Bratwurst04/Kobra-Max-SKR3EZ-Klipper/README.md

# Anycubic Kobra Max with BTT SKR 3 EZ running Klipper
This repository documents my conversion of an original Anycubic Kobra Max to a BIGTREETECH SKR 3 EZ running Klipper.
The build retains most of the original printer hardware, including the Bowden extruder, motors, fans, external bed MOSFET and LeviQ strain-gauge probe.

This is primarily my own build record, and secondarily a reference for similar conversions. Start with the [dated status and intended Orca workflow](./docs/STATUS.md), then use the detailed documents below. The public cfg files remain an older reference, not the complete configuration read from the machine on 28 October 2026.

> [!WARNING]
> This repository is very much a work in progress!
> The wiring and earlier configurations have historical test reports from **my** Anycubic Kobra Max and SKR 3 EZ. The files in this tree have missing prerequisites and explicit local-identity placeholders; they are not a ready-to-run conversion package.
> Anycubic used multiple board and harness revisions, so verify all wiring, voltages, polarities and motor coil pairs on your own machine.
> Do not blindly copy configuration values. Incorrect wiring or configuration can damage hardware.

## Project overview

| Component | Documented build |
|---|---|
| Printer | Original Anycubic Kobra Max |
| Mainboard | BIGTREETECH SKR 3 EZ |
| MCU | STM32H723 |
| Stepper drivers | 4 × BTT EZ2209 v1.1 using UART |
| Host | Raspberry Pi Zero 2 W |
| Interface | Mainsail and Moonraker |
| Firmware | Klipper |
| Extruder | Original Bowden extruder |
| Hotend | Original-style replacement; exact installed model and sensor part unconfirmed. `EPCOS 100K B57560G104F` is the configured profile, not a physical part identification |
| Z probe | Original LeviQ strain gauge |
| Heated bed | Original bed and external MOSFET |
| Adaptive mesh | KAMP |

## What is documented

- Verified Anycubic-to-SKR wiring
- Original LeviQ probe output, reset and LED signals
- Logic-level conversion for the 5 V toolhead signals
- Stepper motor coil mapping
- Dual-Z wiring and synchronization issues
- External bed MOSFET wiring
- Split Klipper configuration files
- KAMP adaptive meshing and line purge
- Problems encountered during the conversion

## Documentation

| Document | Description |
|---|---|
| [Dated status](./docs/STATUS.md) | October read-only observations, laptop test readiness and remaining evidence limits |
| [Wiring](./docs/Wiring.md) | Verified connector mapping, voltages, motor coils and functional tests |
| [Configuration](./docs/config/config.md) | Purpose of each cfg file and values that must be changed or calibrated |
| [Issues](./docs/Issues.md) | Symptoms, causes and fixes encountered during the conversion |
| [Useful links](./Useful_links.md) | External projects, guides and discussions used during the build |
| [STL files](./docs/stl/) | Modified mounting and printhead parts used in this build |
| [Hardware](./docs/Hardware.md) | Exact hardware inventory, retained components, replacements and pending additions |
| [Project journey](./docs/Journey.md) | Chronological development history, failures, discoveries and verified conclusions |
| [Audit index](./AUDIT_REPORT.md) | English summary and immutable source for the historical September audit |
| [Repository working rules](./AGENTS.md) | Evidence, privacy and change-review rules for human and AI contributors |

## Historical verification record

The table below preserves the reports available to the September documentation. On **28 October 2026**, I reported no known current fault; the read-only snapshot and a laptop export were checked, but no laptop print or physical test was performed. Read [dated status](./docs/STATUS.md) before interpreting an old “pending” or “unresolved” label as today's machine state. Earlier success and later open reports both remain part of the history.

| Function | Status | Notes |
|---|---|---|
| X/Y/Z motion | ✅ Verified | Original motors |
| Extruder motion | ⚠️ Partially verified | Motion verified; later intermittent skipping/filament grinding unresolved |
| X/Y endstops | ✅ Verified | Original two-wire endstops |
| Original LeviQ | ⚠️ Reliability reopened | PB15/PB14 mapping verified; later intermittent trigger shifts remain unresolved |
| Z homing | ⚠️ Reliability reopened | Earlier success; later failed/false-trigger homing not closed |
| Hotend and thermistor | ⚠️ Partially verified | `Generic 3950` produced apparent underheating and severe extrusion resistance; reverting to the EPCOS-style curve improved manual 210 °C extrusion. Final PID/flow/max-flow/PA retests remain incomplete |
| Bed heater and MOSFET | ✅ Verified | Original external MOSFET retained |
| Original fans | ✅ Verified | Part-cooling and hotend fans |
| Toolhead LED | ✅ Verified | Controlled through PE5 |
| KAMP adaptive mesh | ⚠️ Integration verified | Adaptive mesh/line purge worked; later LeviQ reliability remains open |
| Pressure Advance | ⚠️ Retune pending | Earlier values were measured under previous Bowden/hotend states; latest hotend/thermistor rollback requires another PA calibration |
| Input Shaper | ✅ Calibration completed | X/Y MZV results recorded; later fast-print observations exist, but no controlled before/after ringing comparison or final saved cfg was supplied |
| Nozzle cleaner | ⚠️ Initial operation reported | Bed-mounted cleaner; final macro/start-sequence version not supplied |
| Host network | ⚠️ Unresolved / reopened | Later access outages remain unclosed |
| Filament runout sensor | ⏳ Pending | Wiring mapped to PC2; automatic start check and pause behavior were planned but not yet functionally verified |

The dated tuning and upgrade reports supplement the separate LeviQ/network investigations; their cross-branch order is not fully established. Earlier successes do not close those later-reported faults. The [configuration guide](./docs/config/config.md#input-shaper-and-nozzle-cleaner-versus-this-snapshot) distinguishes machine reports from features absent in the published cfg files.

## Intended everyday workflow

**Power on → open OrcaSlicer (Moonraker/Mainsail when needed) → Print.** This is the target workflow. The earlier working reference belongs to the home PC; laptop printing remains untried. The exact reviewed cube export passed static file checks only. Its first attended readiness and print session is still required; [status](./docs/STATUS.md) records the boundaries and known start-chain questions.

---

## Modifications

<details>
<summary><strong>Mainboard and chassis</strong></summary>

The original motherboard was replaced with a BTT SKR 3 EZ using four EZ2209 UART stepper drivers.

The board is mounted using a modified version of [this SKR 3 adapter](https://www.thingiverse.com/thing:6247028). My version is available here:

- [Kobra Max SKR 3 adapter plate](./docs/stl/Kobra%20Max%20SKR3%20Adapter%20plate.stl)

The modified plate moves the mounting holes and allows ordinary 3 mm screws instead of heat-set inserts.

The chassis was cut to provide access to the SKR microSD slot and USB-B connector. The exposed metal edges were covered after cutting.

</details>

<details>
<summary><strong>Wiring</strong></summary>

The original harnesses were mapped, depinned, re-crimped and moved into connector housings compatible with the SKR 3 EZ.

Most of the original wires are black, so every conductor was labelled before the original connectors were removed.

The complete verified mapping is documented in [Wiring.md](./docs/Wiring.md).

</details>

<details>
<summary><strong>Printhead and hotend</strong></summary>

The original printhead cover broke and was replaced with a heavily modified version of [this model](https://www.thingiverse.com/thing:5380573).

The modified files are available in [`docs/stl`](./docs/stl/).

The replacement cover required additional clearance around the LeviQ load cell. Insufficient clearance caused false probe triggers.

The original hotend was damaged and replaced with a similar original-style hotend.

</details>

<details>
<summary><strong>Display</strong></summary>

The original Anycubic display is not used in this build. It is proprietary and is not directly supported by the current Klipper configuration.

Mainsail is used as the primary interface.

</details>

## Work recorded before the October return

These items preserve earlier development questions. S01 now captures definitions that were absent from the public reference, including wipe and runout setup; configuration presence does not establish physical function. Use the [dated status](./docs/STATUS.md) for the current scope.

### Tuning

- PLA temperature/flow trials and X/Y Input Shaper calibration completed; see [the tuning follow-up](./docs/Journey.md#tuning-and-hardware-upgrade-follow-up)
- Retraction result inconclusive; sustained maximum flow and quality-focused speed limits not established
- Post-shaper fast-print observations are documented, but no controlled before/after ringing comparison was supplied
- Hotend sensor-profile troubleshooting now favors the published EPCOS-style curve on this machine; final PID, flow, max-flow and PA retests after the latest hotend work are still pending
- Intermittent extrusion and thermistor history remains relevant alongside LeviQ/network reliability

### Accessories

- Filament runout sensor
- USB accelerometer used for calibration; final live configuration not included
- Bed-mounted nozzle cleaner initially working; final start-sequence validation not documented
- Optional KlipperScreen display
- Raspberry Pi and USB-hub enclosures

### Possible future upgrades

- Quieter power-supply fan
- Direct drive
- Different hotend or printhead
- PEI build surface
- Chassis LED strip
- Replacement X/Y/Z motors
- Home Assistant integration
- Eddy-current probe

## How-to guide

A full start-to-finish installation guide is not available yet.

For now, the repository should be treated as:

1. A verified wiring reference
2. A [machine-specific reference configuration snapshot](./docs/config/config.md#published-snapshot-and-host-state), with prerequisites and limitations documented there
3. A record of problems and solutions from the conversion, with [dated evidence limits](./docs/STATUS.md)

> [!CAUTION]
> Always confirm your own board revision, MCU model and wiring before following this repository.
