Bratwurst04/Kobra-Max-SKR3EZ-Klipper/Useful_links.md

# Useful links

This page collects external projects, guides and discussions used while researching the Anycubic Kobra Max conversion.

> [!NOTE]
> These links were used as references, clues or comparison material.
> They do not necessarily match this exact hardware revision or final wiring. The verified information for this build is documented in [Wiring.md](./docs/Wiring.md) and the cfg files in [`docs/config`](./docs/config/).

## GitHub projects

| Resource | Why it was useful |
|---|---|
| [SWIO Kobra Max Adapter Kit](https://github.com/smartwareio/SWIO-Kobra-Max-Adapter-Kit) | Toolhead signal names, 5 V logic warnings, adapter-board layout and Kobra Max conversion reference |
| [fuegovic/kobra-max-klipper-backup](https://github.com/fuegovic/kobra-max-klipper-backup) | Existing Kobra Max Klipper configuration and comparison material |
| [ryanpie86/Anycubic-Kobra-Max-Klipper-Conversion](https://github.com/ryanpie86/Anycubic-Kobra-Max-Klipper-Conversion) | Another complete Kobra Max conversion project |
| [invisiblek Klipper config — Kobra Plus branch](https://github.com/invisiblek/klipper_config/tree/kobraplus) | Related Anycubic configuration and implementation ideas |

## Guides and product references

| Resource | Why it was useful |
|---|---|
| [SmartwareIO Kobra Max mainboard and printhead kit](https://www.smartwareio.com/product/kobra-max-mainboard-and-print-head-kit/9) | Photos and description of the Kobra Max adapter approach |
| [iFixit: Installing Klipper on SKR 3 EZ](https://www.ifixit.com/Guide/4.+Installing+Klipper+on+SKR3+EZ/152185) | SKR 3 EZ Klipper installation and firmware reference |

## Upgrade comparison reference

| Resource | Why it was useful |
|---|---|
| [Kobra Max Direct Drive Mount by Thebeatbandit](https://www.thingiverse.com/thing:5420549) | Linked in the hardware-upgrade discussion as a possible way to relocate the original extruder; not reported printed, fitted or tested on this machine |

The hotend product comparisons used supplied listing PDFs. Their advertised specifications and unverified installation status are recorded in [Hardware.md](./docs/Hardware.md#upgrade-candidates-not-installed-hardware); they are not additions to the verified hardware inventory.

## Reddit discussions

| Resource | Why it was useful |
|---|---|
| [Any interest in a Kobra Max Klipper package?](https://www.reddit.com/r/anycubic/comments/12a2fqp/any_interest_in_a_kobra_max_klipper_package/) | Community discussion about Kobra Max Klipper support |
| [Anycubic Kobra working config](https://www.reddit.com/r/anycubic/comments/ynvbj0/anycubic_kobra_working_config/) | Early configuration discussion and possible pin/config clues |

---

> [!IMPORTANT]
> This list is incomplete.
>
> Additional sources were consulted during troubleshooting but were not saved at the time.
