Bratwurst04/Kobra-Max-SKR3EZ-Klipper/docs/stl/Kobra max head 2.stl

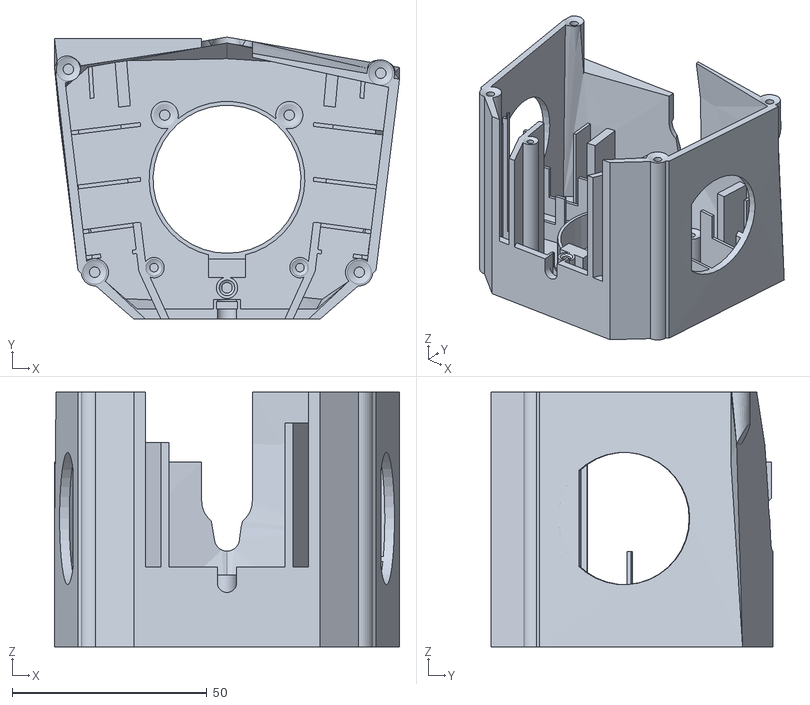
[picture p1: CAD file, 2026-08-02]
docs/stl/Kobra max head 2.stl
88.6 x 72.4 x 65.5
