Bratwurst04/Kobra-Max-SKR3EZ-Klipper/docs/stl/Kobra max head 2 infill.stl

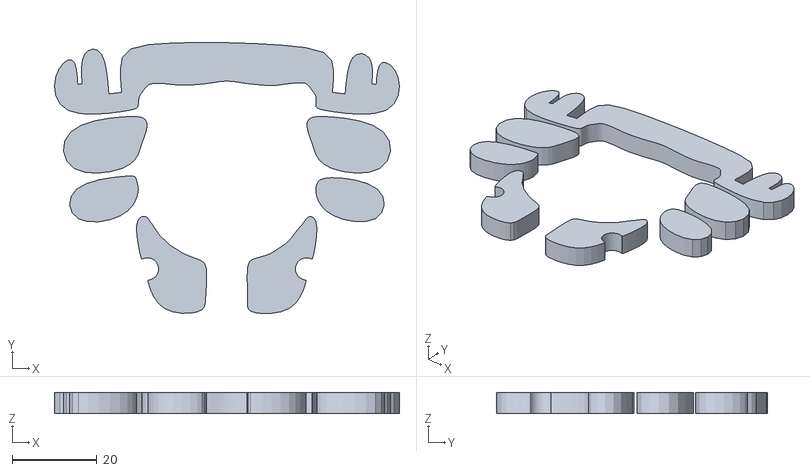
[picture p2: CAD file, 2026-08-02]
docs/stl/Kobra max head 2 infill.stl
81.3 x 63.9 x 5.00
