Bratwurst04/Kobra-Max-SKR3EZ-Klipper/docs/stl/Kobra Max SKR3 Adapter plate.stl

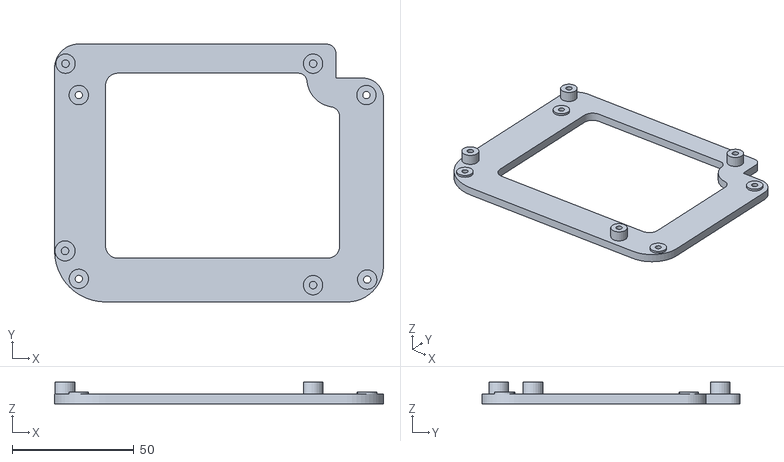
[picture p3: CAD file, 2026-08-02]
docs/stl/Kobra Max SKR3 Adapter plate.stl
135.2 x 106.0 x 9.00
