Bratwurst04/Kobra-Max-SKR3EZ-Klipper/docs/config/tmc.cfg

# BTT SKR 3 EZ v1.0
# BTT EZ2209 v1.1

[tmc2209 stepper_x]
uart_pin: PD5
run_current: 0.70
hold_current: 0.40
interpolate: True
stealthchop_threshold: 0

[tmc2209 stepper_y]
uart_pin: PD0
run_current: 0.70
hold_current: 0.40
interpolate: True
stealthchop_threshold: 0

[tmc2209 stepper_z]
uart_pin: PE1
run_current: 0.70
hold_current: 0.40
interpolate: True
stealthchop_threshold: 0

[tmc2209 extruder]
uart_pin: PC6
run_current: 0.80
hold_current: 0.40
interpolate: True
stealthchop_threshold: 0
