Bratwurst04/Kobra-Max-SKR3EZ-Klipper/(commit log)

2026-08-01 Create Wiring
2026-08-02 Rename Anycubic Kobra Max Klipper - Blad1-9-1.png to Anycubic_Kobra_Max_Klipper.png
2026-08-02 Added current working config files
    Will be updating them when next feature is working
    [bed.cfg, fans.cfg, leviq_probe.cfg, macros.cfg, printer.cfg, steppers.cfg, tmc.cfg]
2026-08-02 Add files via upload
    Kobra Max Head files and motherboard adapter file
    [Kobra Max SKR3 Adapter plate.stl, Kobra max head 2 infill.stl, Kobra max head 2.stl]
2026-08-02 Update Wiring.md to V1
    A lot more info
2026-09-17 docs: add post-shaper thermistor and runout follow-up
2026-09-17 docs: apply approved audit corrections without changing printer settings
    [fans.cfg]
2026-10-29 Update dated backup and Klipper source evidence
